Gill003/Semi-Autonomous-RC-Car/images/PID_Controller_Feedback_Loop.pdf

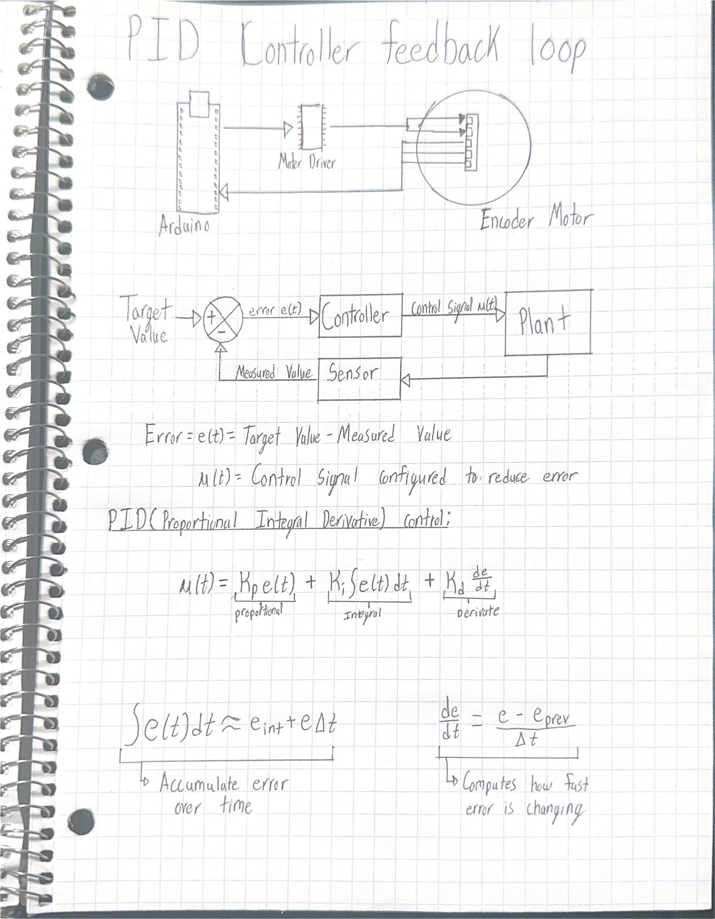
[picture p4: page 1]
