Gill003/Semi-Autonomous-RC-Car/images/RCPic8.jpg

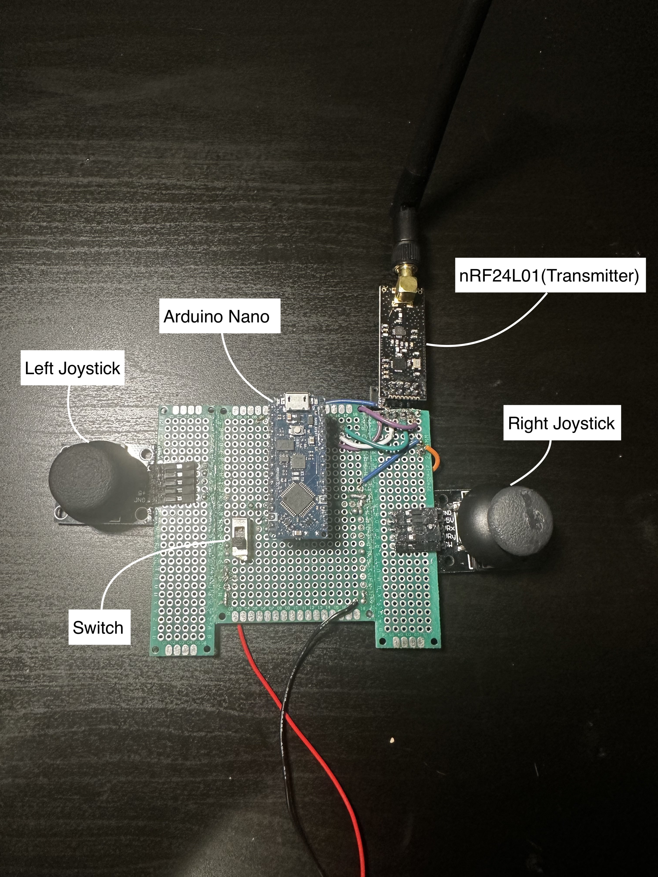
images/RCPic8.jpg
