Gill003/Semi-Autonomous-RC-Car/PCB Design RCCAR.png

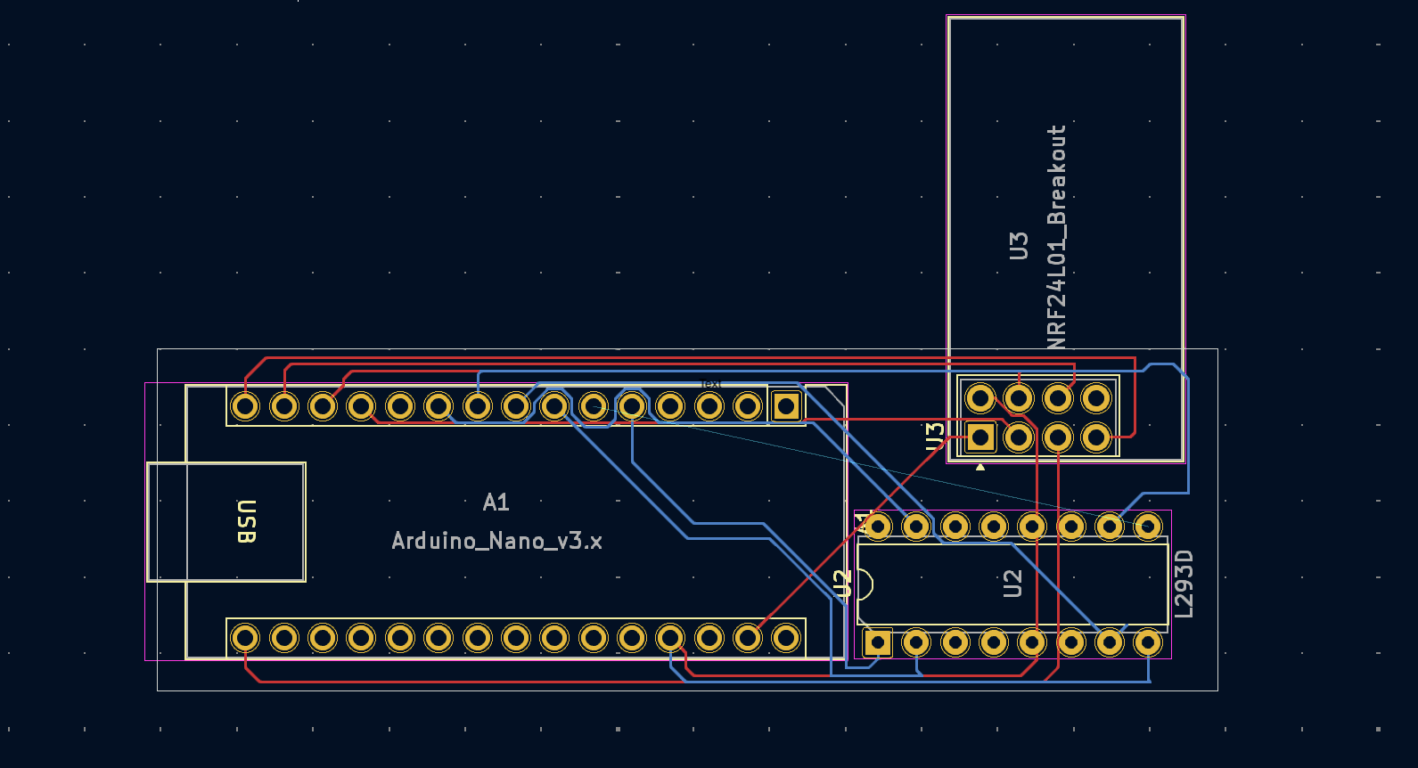
PCB Design RCCAR.png
